AlexanderSjoholm/HexBot/README.md

HexBot
======

En sexbent spindel som autonomt rör sig i en kvadratisk värld och kartlägger den kontinuerligt.

Projektet var en del i CDIO kursen TSEA27 vid Linköpings Universitet, 2012.
