AlexanderSjoholm/HexBot/Moduler/Sensor/adc.c

#include<avr/io.h>
#include<stdlib.h>
#include <avr/interrupt.h>
#include <adc.h>

unsigned char adc_ch = 0;
volatile unsigned char mode = 0;
unsigned char measurements[6] = {0};
unsigned char reads = 0;
unsigned char mesurement = 0;

unsigned char side_wall = 0;
//Direction anger vilken sensor som pekar framåt.
unsigned char direction = 0;

void ADCinit()
{
	ADCSRA |= (1<<ADEN)|(1<<ADIE)|(1<<ADPS1)|(1<<ADPS0); // set adc-prescaler, set adc enable and adc interrupt enable
	ADMUX |= (1<<REFS0) | (1 << ADLAR); // set adv vcc ref
	ADMUX |= adc_ch;
}

//läser av alla ir-sensorer och sparar ner dessa
void read_sensors()
{
	if(mode != read_mode)
	{
		mode = read_mode;
		TWCR &= ~(1<<TWEN);
		adc_ch = 0;
		ADMUX &= 0xE0;
		ADCSRA |= (1 << ADSC);
	}

}

unsigned char get_measurements(unsigned char sensor)
{
	return measurements[sensor];
}

void set_measurements(unsigned char sensor, unsigned char data)
{
	measurements[sensor] = data;
}
/*
unsigned char decide_side_wall()
{
	read_sensors();

	//Vänta tills alla avläsningar är klara
	while(mode != no_mode);
	
	unsigned char i = 0;
	unsigned char value = abs((get_measurements(0, 0) / 2) + (get_measurements(5, 0) / 2) - side_wall_dist_1);
	direction = 1;
	side_wall = 3;
	
	//Då igenom alla sensorer
	for(i = 0; i < 5; i++)
	{
		unsigned char temp;
		temp = abs((get_measurements(i + 1, 1) / 2) + (get_measurements(i, 1) / 2) - side_wall_dist_1);
		
		if(temp < value)
		{
			value = temp;

			direction = i + 2;
			//Sätter side_wall så att den matchar med det ben som pekar mot närmast parallella vägg
			side_wall = 2 - i;
			if (side_wall < 1)
			{
				side_wall += 6;
			}
		}
		
		
	}

	//Som direction % 6
	if(direction == 6)
	{
		direction -= 6;
		return 0;
	}
	return direction;	
}
*/


ISR(ADC_vect)
{
	//unsigned char direction_correction = direction;
	switch(mode)
	{	
		case read_mode:
		{
			
				unsigned char adc = ADCH;
				set_measurements(adc_ch, adc);
				if(adc_ch < 6)
				{
					adc_ch += 1;
					ADMUX += 1;
					ADCSRA |= (1 << ADSC);

				}
				else
				{
					adc_ch = 0;
					ADMUX &= 0xE0;
					mode = no_mode;
					TWCR |= (1<<TWEN);
				}

			
		}
		break;
		
	}

	//direction = direction_correction;
} 
